randohinn/RVP/Hardware/WeP_reciever/RVP.pdf

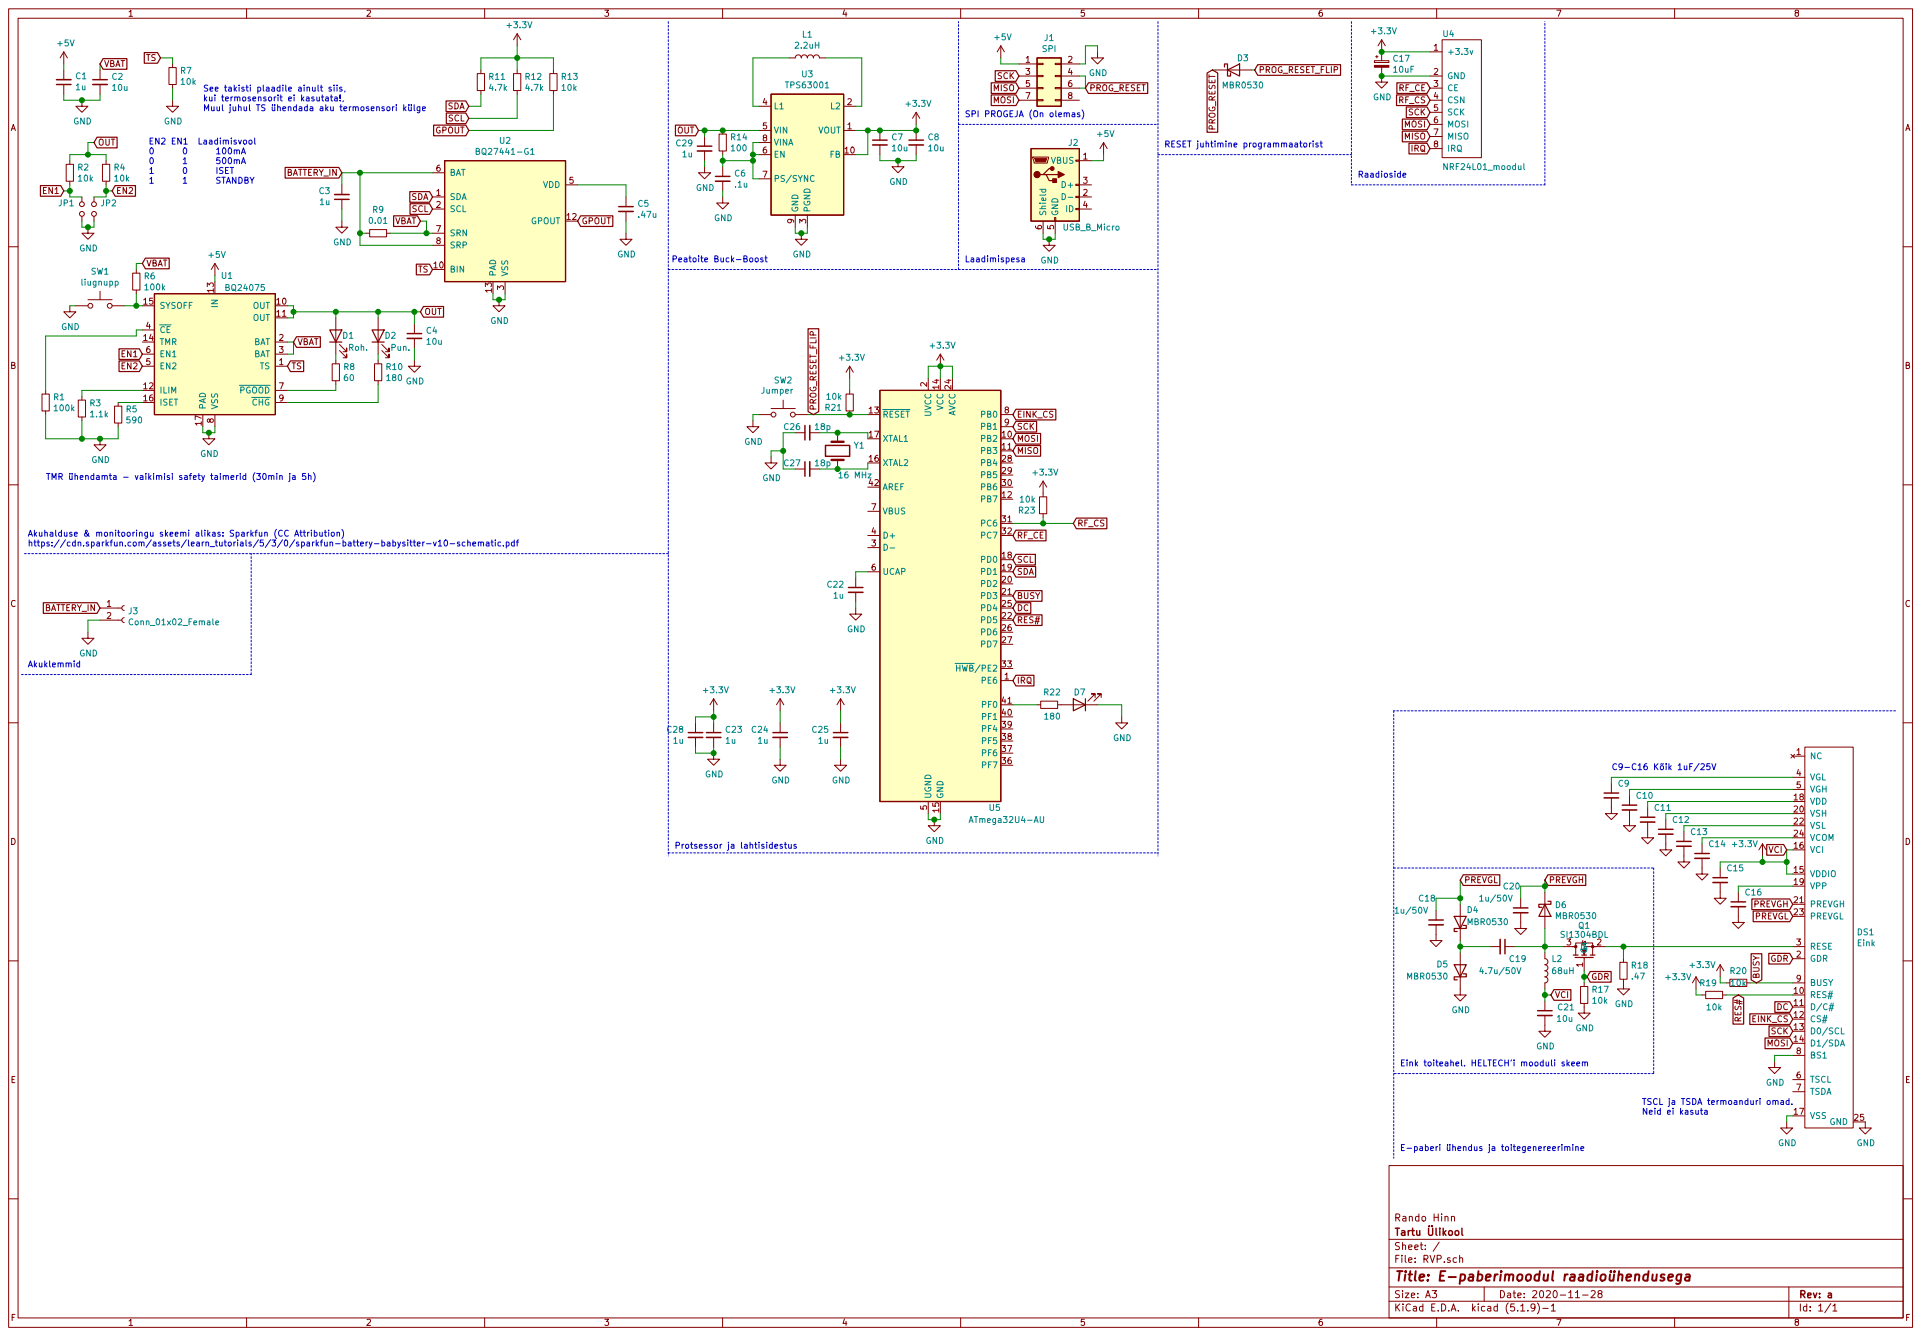
[picture p1: page 1]

See takisti plaadile ainult siis, kui termosensorit ei kasutata!, Muul juhul TS ühendada aku termosensori külge

3 VDD 5 BAT 6 SRN 7 SRP 8 U2 BQ27441-G1 C9

2 PD2 20 PD3 21 PD5 22 AVCC 24 PD4 25 PD6 26 PD7 27 PB4 28 PB5 29 D- 3 PB6 30 PC6 31 PC7 32 HWB/PE2 33 PF7 36 PF6 37 PF5 38 PF4 39 D+ 4 PF1 40 PF0 41 AREF 42 UGND

https://cdn.sparkfun.com/assets/learn_tutorials/5/3/0/sparkfun-battery-babysitter-v10-schematic.pdf Akuklemmid TMR ühendamta - vaikimisi safety taimerid (30min ja 5h)

Akuhalduse & monitooringu skeemi alikas: Sparkfun (CC Attribution)

Eink toiteahel. HELTECH'i mooduli skeem

TSCL ja TSDA termoanduri omad. Neid ei kasuta

File: RVP.sch Sheet: / Tartu Ülikool Rando Hinn

Id: 1/1 Title: E-paberimoodul raadioühendusega
