randohinn/RVP/Hardware/WeP_transmitter/RVP_saatja.pdf

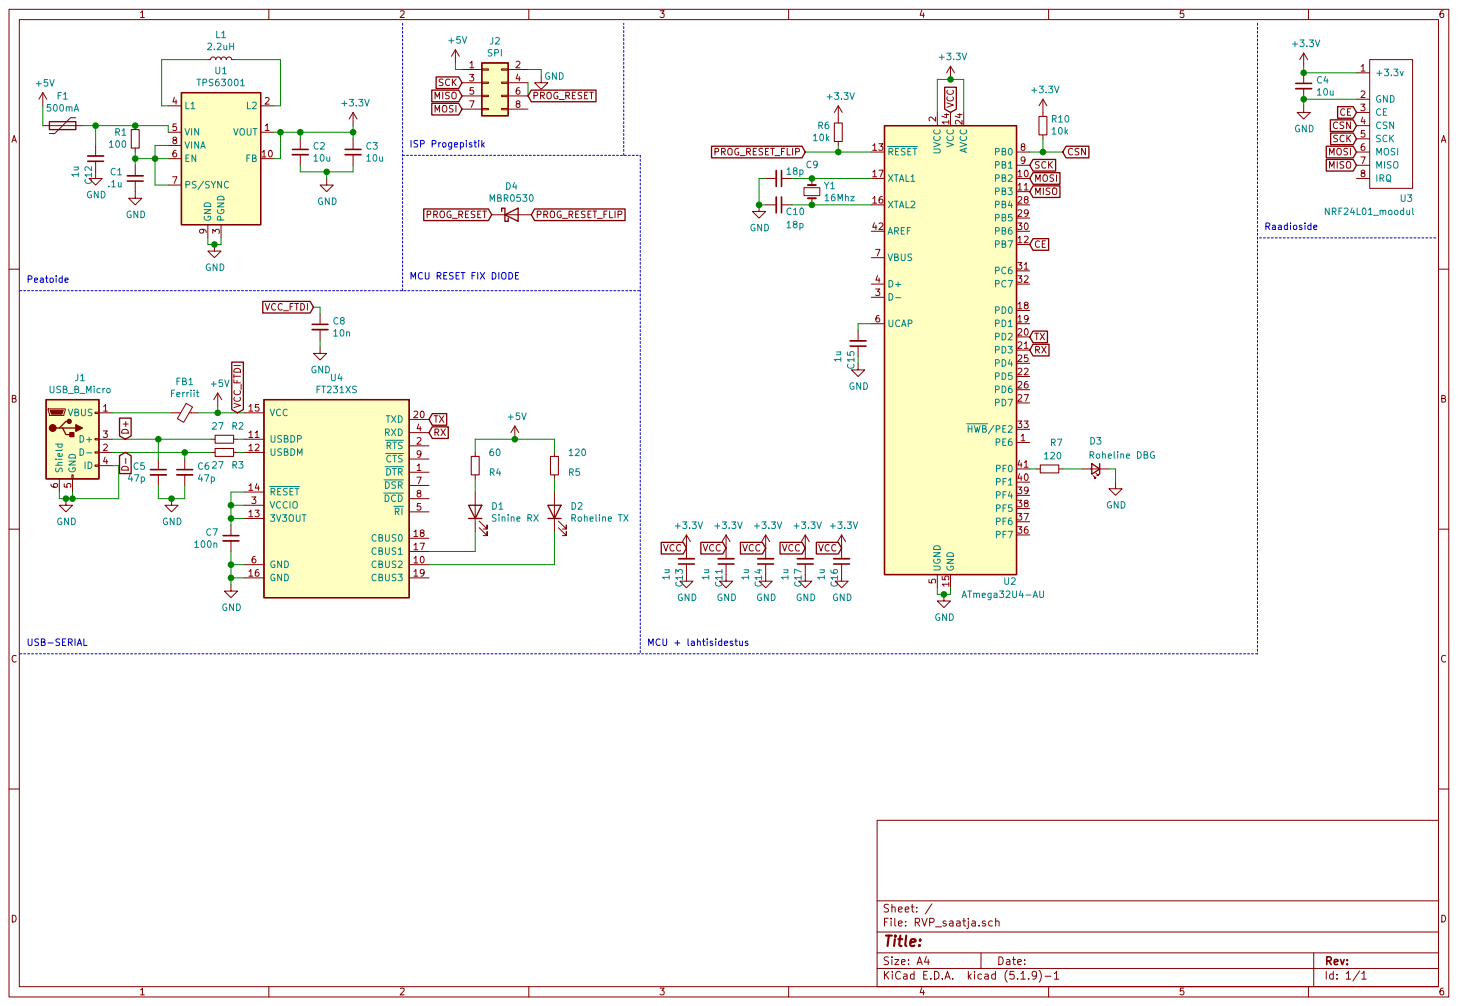
[picture p2: page 1]

9 U1 TPS63001 PE6 1 PB2 10 PB3 11 PB7 12 RESET 13 VCC 14 GND 15 XTAL2 16 XTAL1 17 PD0 18 PD1 19 UVCC

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
