randohinn/RVP/Hardware/WeP_reciever/RVP.kicad_pcb

## KiCad design Hardware/WeP_reciever/RVP.kicad_pcb (2021-02-10)

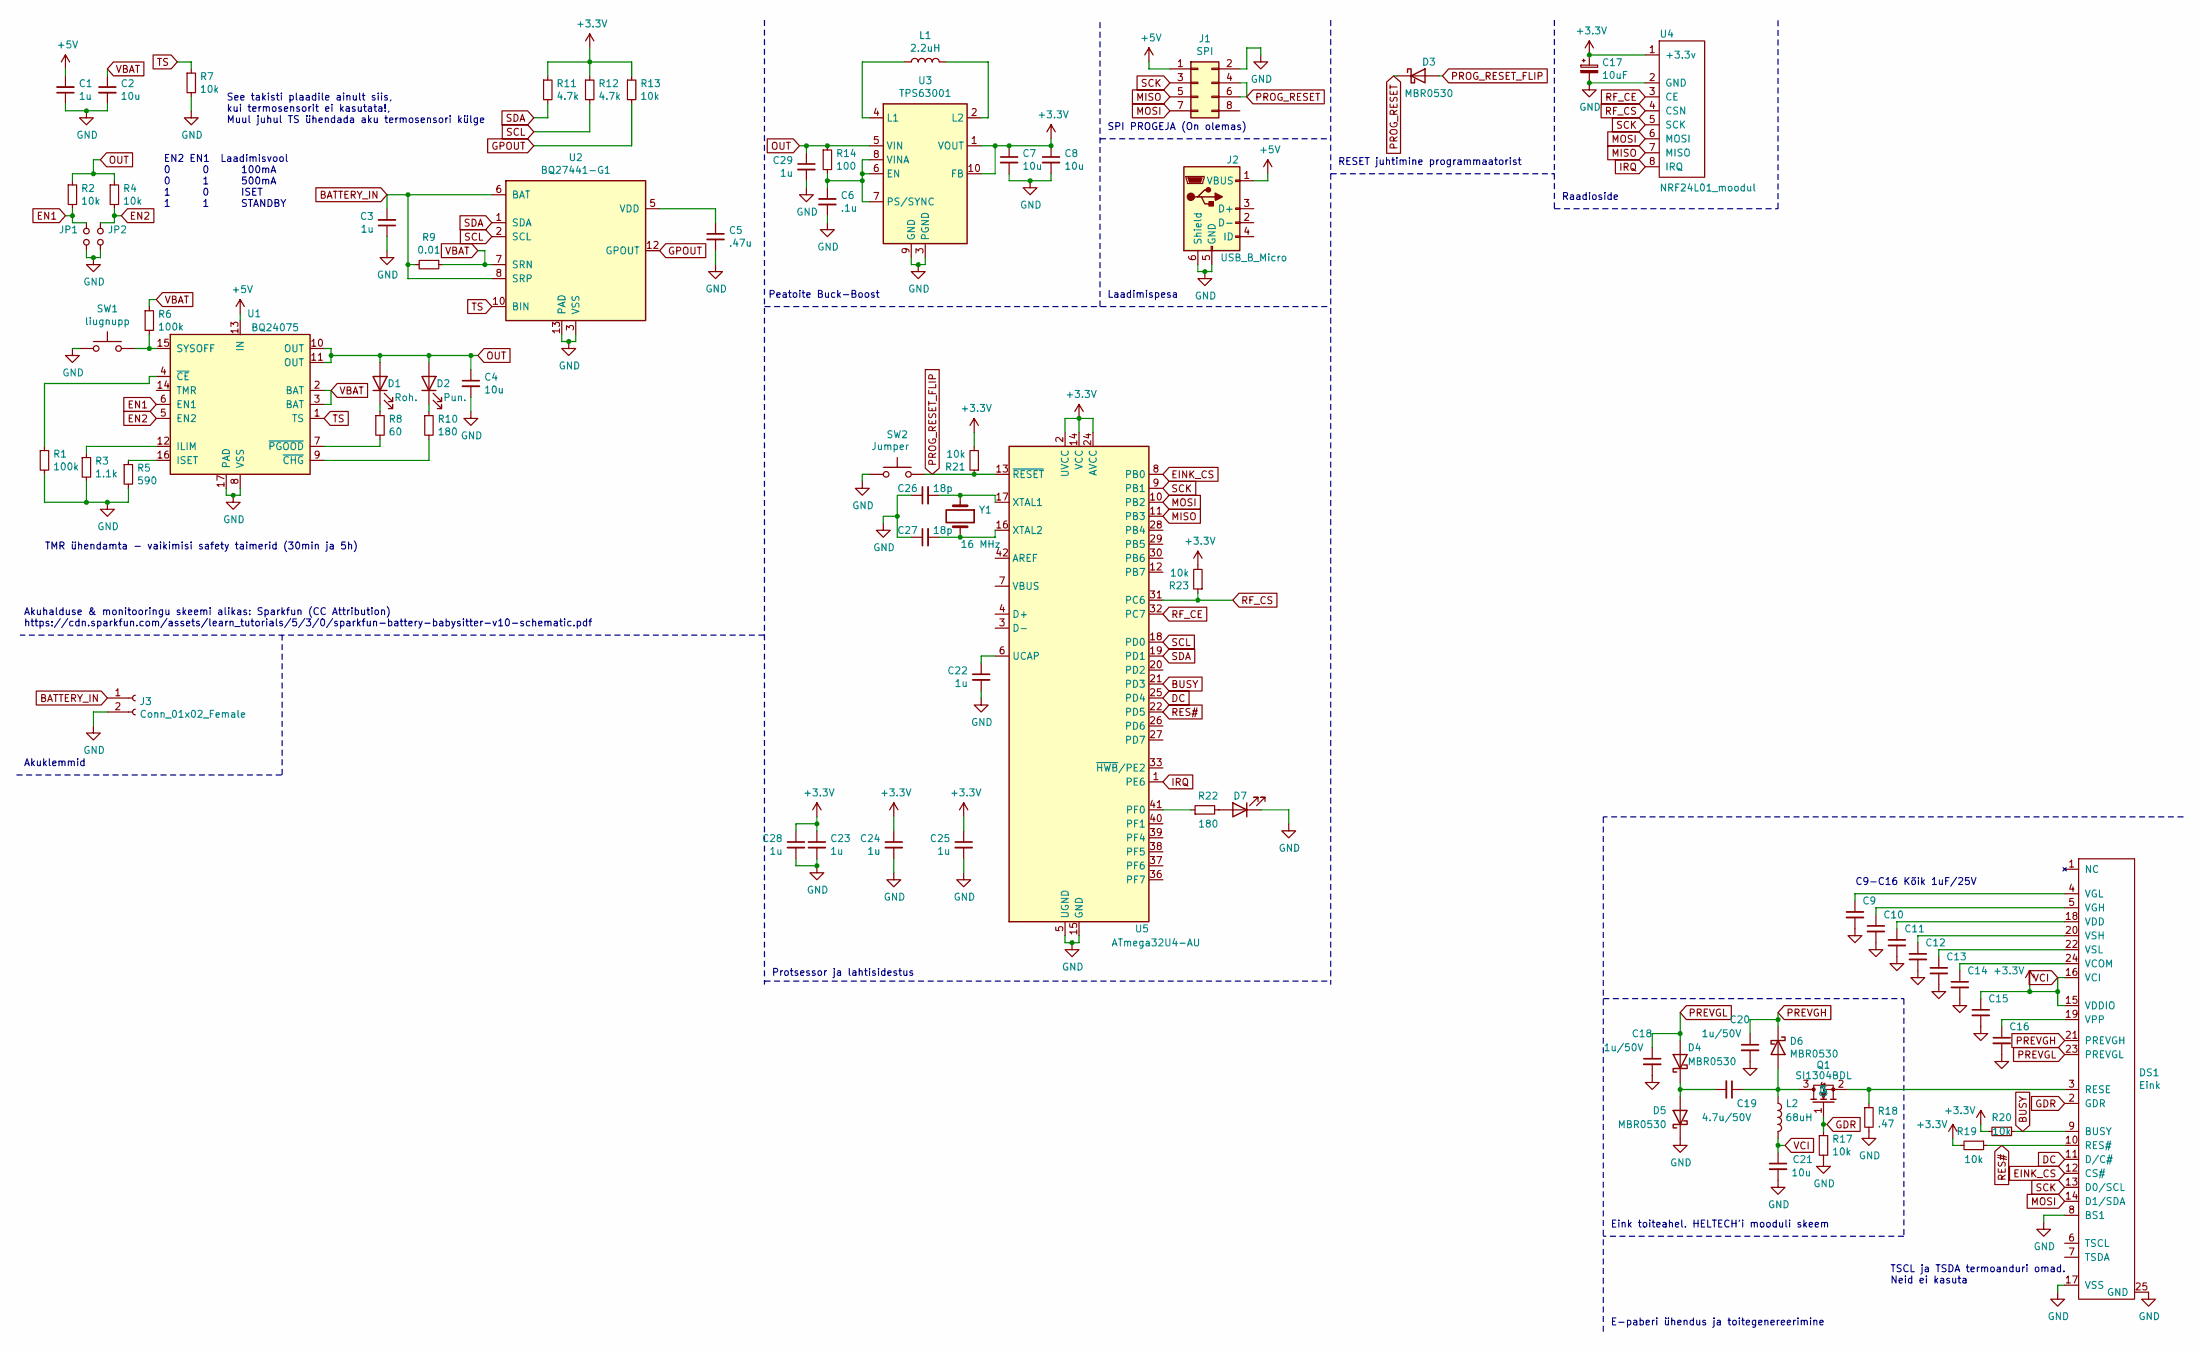
[picture p3: schematic RVP.sch, E-paberimoodul raadioühendusega]

Parts:
C1, C3, C9, C10, C11, C12, C13, C14, C15, C16, C22, C23, C24, C25, C28, C29: 1u; C_0603_1608Metric
C2, C4, C7, C8, C21: 10u; C_0603_1608Metric
C5: .47u; C_0603_1608Metric
C6: .1u; C_0603_1608Metric
C17: 10uF; CP_EIA-3528-15_AVX-H
C18, C20: 1u/50V; C_0603_1608Metric
C19: 4.7u/50V; C_0603_1608Metric
C26, C27: 18p; C_0603_1608Metric
D1: Roh.; LED_0603_1608Metric
D2: Pun.; LED_0603_1608Metric
D3, D4, D5, D6: MBR0530; D_SOD-123
D7: Sinine; LED_0603_1608Metric
DS1: Eink
J1: SPI; PinHeader_2x04_P2.54mm_Vertical
J2: USB_B_Micro; USB_Micro-B_Amphenol_10104110_Horizontal
J3: Conn_01x02_Female; Solderpads
JP1, JP2: Jumper_NO_Small; SolderJumper-2_P1.3mm_Open_Pad1.0x1.5mm
L1: 2.2uH; L_0603_1608Metric
L2: 68uH; L_0603_1608Metric
Q1: SI1304BDL; SOT-323_SC-70_Handsoldering
R1, R6: 100k; R_0603_1608Metric
R2, R4, R7, R13, R17, R19, R20, R21, R23: 10k; R_0603_1608Metric
R3: 1.1k; R_0603_1608Metric
R5: 590; R_0603_1608Metric
R8: 60; R_0603_1608Metric
R9: 0.01; R_0603_1608Metric
R10, R22: 180; R_0603_1608Metric
R11, R12: 4.7k; R_0603_1608Metric
R14: 100; R_0603_1608Metric
R18: .47; R_0603_1608Metric
SW1: liugnupp; MK12C02
SW2: Jumper; C_0603_1608Metric
U1: BQ24075; VQFN-16-1EP_3x3mm_P0.5mm_EP1.68x1.68mm
U2: BQ27441-G1; Texas_S-PDSO-N12
U3: TPS63001; Texas_DRC0010J_ThermalVias
U4: NRF24L01_moodul; NRF24L01 moodul SMD
U5: ATmega32U4-AU; TQFP-44_10x10mm_P0.8mm
Y1: 16 MHz; Crystal_SMD_TXC_7A-2Pin_5x3.2mm

Connections:
+5V: C1.2, J1.1, J2.1 (VBUS), U1.13 (IN)
BATTERY_IN: C3.2, J3.1, R9.2, U2.6 (BAT), U2.8 (SRP)
BUSY: DS1.9 (BUSY), R20.1, U5.21 (PD3)
DC: DS1.11 (D/C#), U5.25 (PD4)
EINK_CS: DS1.12 (CS#), U5.8 (PB0)
EN1: JP1.1, R2.2, U1.6 (EN1)
EN2: JP2.1, R4.2, U1.5 (EN2)
GDR: DS1.2 (GDR), Q1.1 (G), R17.1
GND: C1.1, C2.2, C3.1, C4.2, C5.2, C6.2, C7.2, C8.2, C9.2, C10.2, C11.2, C12.2, C13.2, C14.2, C15.2, C16.2, C17.2, C18.2, C20.2, C21.2, C22.2, C23.2, C24.2, C25.2, C26.1, C27.1, C28.2, C29.2, D5.1 (K), D7.1 (K), DS1.8 (BS1), DS1.17 (VSS), DS1.25 (GND), J1.2, J2.5 (GND), J2.6 (Shield), J3.2, JP1.2, JP2.2, R1.2, R3.2, R5.2, R7.2, R17.2, R18.2, SW1.2, SW2.1, U1.8 (VSS), U1.17 (PAD), U2.3 (VSS), U2.13 (PAD), U3.3 (PGND), U3.9 (GND), U3.11 (PGND), U4.2 (GND), U5.5 (UGND), U5.15 (GND), U5.23 (GND), U5.35 (GND), U5.43 (GND)
GPOUT: R13.2, U2.12 (GPOUT)
IRQ: U4.8 (IRQ), U5.1 (PE6)
MISO: J1.5, U4.7 (MISO), U5.11 (PB3)
MOSI: DS1.14 (D1/SDA), J1.7, U4.6 (MOSI), U5.10 (PB2)
unnamed: C5.1, U2.5 (VDD)
unnamed: C6.1, R14.2, U3.6 (EN), U3.7 (PS/SYNC), U3.8 (VINA)
unnamed: C9.1, DS1.4 (VGL)
unnamed: C10.1, DS1.5 (VGH)
unnamed: C11.1, DS1.18 (VDD)
unnamed: C12.1, DS1.20 (VSH)
unnamed: C13.1, DS1.22 (VSL)
unnamed: C14.1, DS1.24 (VCOM)
unnamed: C16.1, DS1.19 (VPP)
unnamed: C19.1, D6.2 (A), L2.1, Q1.3 (D)
unnamed: C19.2, D4.1 (K), D5.2 (A)
unnamed: C22.1, U5.6 (UCAP)
unnamed: C26.2, U5.17 (XTAL1), Y1.1
unnamed: C27.2, U5.16 (XTAL2), Y1.2
unnamed: D1.1 (K), R8.1
unnamed: D2.1 (K), R10.1
unnamed: D7.2 (A), R22.2
unnamed: DS1.3 (RESE), Q1.2 (S), R18.1
unnamed: L1.1, U3.4 (L1)
unnamed: L1.2, U3.2 (L2)
unnamed: R1.1, U1.4 (~CE)
unnamed: R3.1, U1.12 (ILIM)
unnamed: R5.1, U1.16 (ISET)
unnamed: R6.2, SW1.1, U1.15 (SYSOFF)
unnamed: R8.2, U1.7 (~PGOOD)
unnamed: R10.2, U1.9 (~CHG)
unnamed: R22.1, U5.41 (PF0)
OUT: C4.1, C29.1, D1.2 (A), D2.2 (A), R2.1, R4.1, R14.1, U1.10 (OUT), U1.11 (OUT), U3.5 (VIN)
PREVGH: C20.1, D6.1 (K), DS1.21 (PREVGH)
PREVGL: C18.1, D4.2 (A), DS1.23 (PREVGL)
PROG_RESET: D3.1 (K), J1.4, J1.6
PROG_RESET_FLIP: D3.2 (A), R21.1, SW2.2, U5.13 (~RESET)
RES#: DS1.10 (RES#), R19.1, U5.22 (PD5)
RF_CE: U4.3 (CE), U5.32 (PC7)
RF_CS: R23.1, U4.4 (CSN), U5.31 (PC6)
SCK: DS1.13 (D0/SCL), J1.3, U4.5 (SCK), U5.9 (PB1)
SCL: R12.2, U2.2 (SCL), U5.18 (PD0)
SDA: R11.2, U2.1 (SDA), U5.19 (PD1)
TS: R7.1, U1.1 (TS), U2.10 (BIN)
VBAT: C2.1, R6.1, R9.1, U1.2 (BAT), U1.3 (BAT), U2.7 (SRN)
VCI: C7.1, C8.1, C15.1, C17.1, C21.1, C23.1, C24.1, C25.1, C28.1, DS1.15 (VDDIO), DS1.16 (VCI), L2.2, R11.1, R12.1, R13.1, R19.2, R20.2, R21.2, R23.2, U3.1 (VOUT), U3.10 (FB), U4.1 (+3.3v), U5.2 (UVCC), U5.14 (VCC), U5.24 (AVCC), U5.34 (VCC), U5.44 (AVCC)

Notes on the sheet:
Akuhalduse & monitooringu skeemi alikas: Sparkfun (CC Attribution) https://cdn.sparkfun.com/assets/learn_tutorials/5/3/0/sparkfun-battery-babysitter-v10-schematic.pdf
See takisti plaadile ainult siis, kui termosensorit ei kasutata!, Muul juhul TS ühendada aku termosensori külge
TMR ühendamta - vaikimisi safety taimerid (30min ja 5h)
EN2 EN1 Laadimisvool 0 0 100mA 0 1 500mA 1 0 ISET 1 1 STANDBY
Peatoite Buck-Boost
SPI PROGEJA (On olemas)
Laadimispesa
RESET juhtimine programmaatorist
Raadioside
TSCL ja TSDA termoanduri omad. Neid ei kasuta
Eink toiteahel. HELTECH'i mooduli skeem
C9-C16 Kõik 1uF/25V
E-paberi ühendus ja toitegenereerimine
Protsessor ja lahtisidestus
Akuklemmid

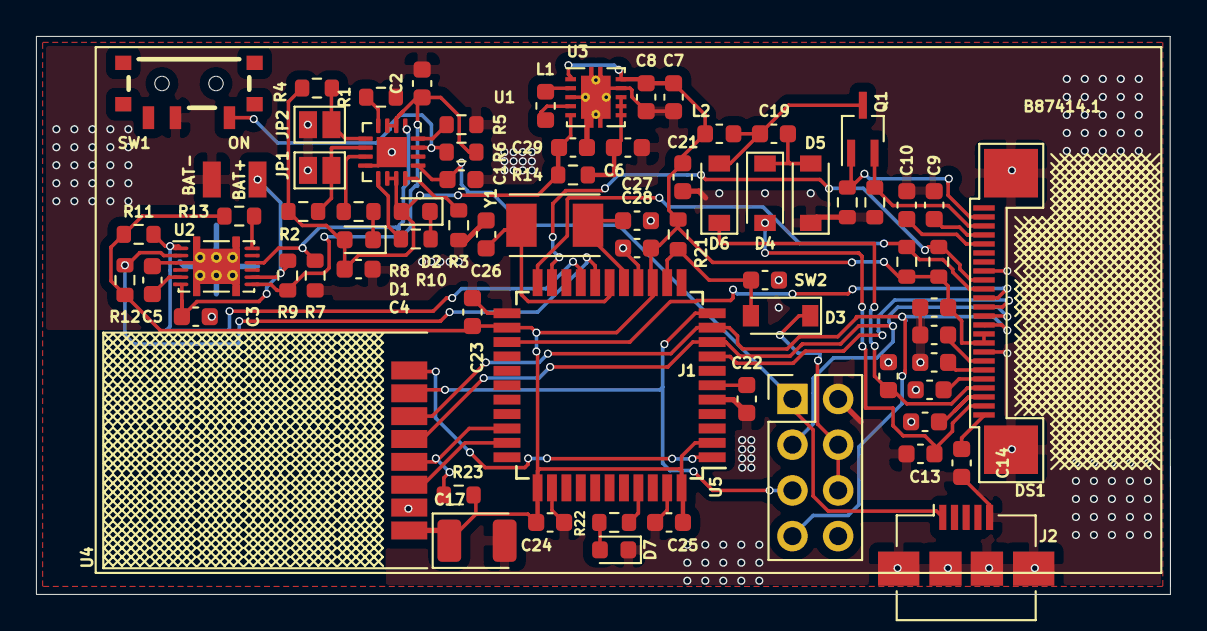
[picture p4: board RVP.kicad_pcb from above]

Board: 2 copper layers, 63.0 x 31.0 mm, 74 parts (0 on the bottom side), 54 nets.
