randohinn/RVP/Hardware/WeP_transmitter/RVP_saatja.kicad_pcb

## KiCad design Hardware/WeP_transmitter/RVP_saatja.kicad_pcb (2021-02-10)

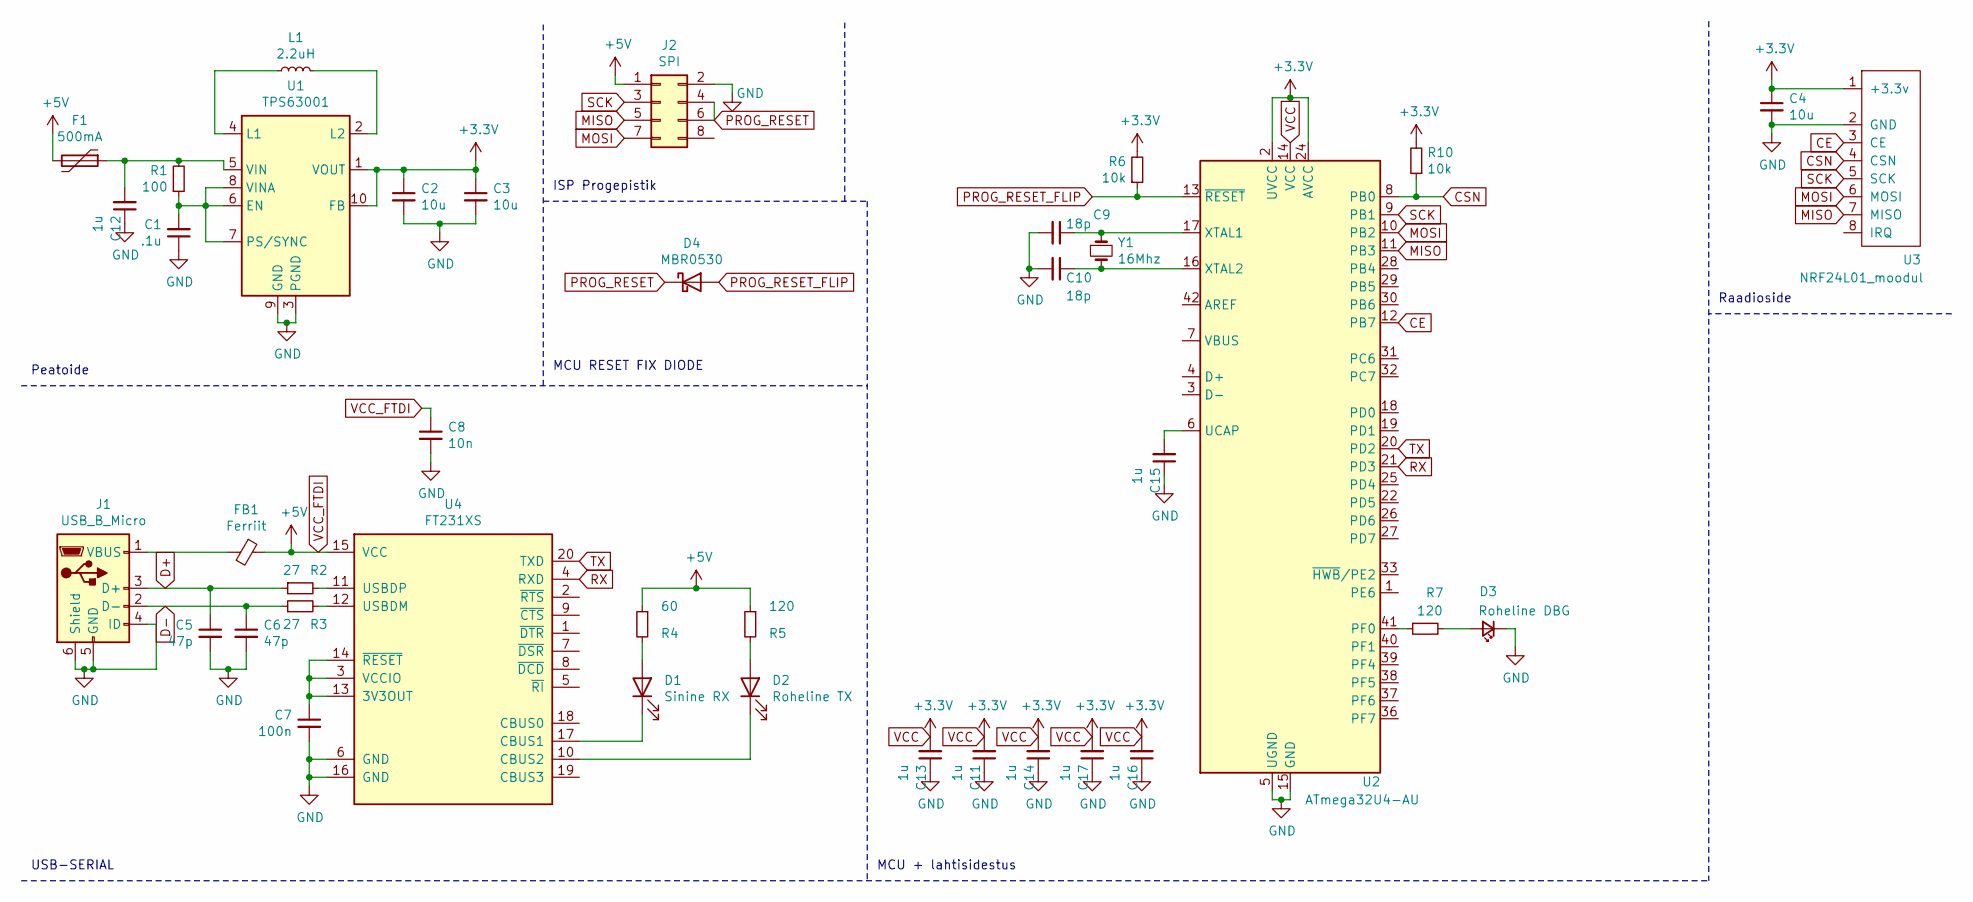
[picture p5: schematic RVP_saatja.sch]

Parts:
C1: .1u; C_0603_1608Metric
C2, C3: 10u; C_0603_1608Metric
C4: 10u; CP_EIA-3528-15_AVX-H
C5, C6: 47p; C_0603_1608Metric
C7: 100n; C_0603_1608Metric
C8: 10n; C_0603_1608Metric
C9, C10: 18p; C_0603_1608Metric
C11, C12, C13, C14, C15, C16, C17: 1u; C_0603_1608Metric
D1: Sinine RX; LED_0603_1608Metric
D2: Roheline TX; LED_0603_1608Metric
D3: Roheline DBG; LED_0603_1608Metric
D4: MBR0530; D_SOD-123
F1: 500mA; Fuse_1206_3216Metric
FB1: Ferriit; L_0603_1608Metric
J1: USB_B_Micro; USB_Micro-B_Amphenol_10104110_Horizontal
J2: SPI; PinHeader_2x04_P2.54mm_Vertical
L1: 2.2uH; L_0603_1608Metric
R1: 100; R_0603_1608Metric
R2, R3: 27; R_0603_1608Metric
R4: 60; R_0603_1608Metric
R5, R7: 120; R_0603_1608Metric
R6, R10: 10k; R_0603_1608Metric
U1: TPS63001; Texas_DRC0010J_ThermalVias
U2: ATmega32U4-AU; TQFP-44_10x10mm_P0.8mm
U3: NRF24L01_moodul; NRF24L01 moodul SMD
U4: FT231XS; SSOP-20_3.9x8.7mm_P0.635mm
Y1: 16Mhz; Crystal_SMD_TXC_7A-2Pin_5x3.2mm

Connections:
CE: U2.12 (PB7), U3.3 (CE)
CSN: R10.1, U2.8 (PB0), U3.4 (CSN)
D+: C5.1, J1.3 (D+), R2.1
D-: C6.1, J1.2 (D-), R3.1
GND: C1.1, C2.2, C3.2, C4.2, C5.2, C6.2, C7.2, C8.2, C9.2, C10.2, C11.1, C12.1, C13.1, C14.1, C15.1, C16.1, C17.1, D3.1 (K), J1.4 (ID), J1.5 (GND), J1.6 (Shield), J2.2, U1.3 (PGND), U1.9 (GND), U1.11 (PGND), U2.5 (UGND), U2.15 (GND), U2.23 (GND), U2.35 (GND), U2.43 (GND), U3.2 (GND), U4.6 (GND), U4.16 (GND)
MISO: J2.5, U2.11 (PB3), U3.7 (MISO)
MOSI: J2.7, U2.10 (PB2), U3.6 (MOSI)
unnamed: C1.2, R1.1, U1.6 (EN), U1.7 (PS/SYNC), U1.8 (VINA)
unnamed: C7.1, U4.3 (VCCIO), U4.13 (3V3OUT), U4.14 (~RESET)
unnamed: C9.1, U2.17 (XTAL1), Y1.1
unnamed: C10.1, U2.16 (XTAL2), Y1.2
unnamed: C12.2, F1.1, R1.2, U1.5 (VIN)
unnamed: C15.2, U2.6 (UCAP)
unnamed: D1.1 (K), U4.17 (CBUS1)
unnamed: D1.2 (A), R4.2
unnamed: D2.1 (K), U4.10 (CBUS2)
unnamed: D2.2 (A), R5.2
unnamed: D3.2 (A), R7.2
unnamed: FB1.2, J1.1 (VBUS)
unnamed: L1.1, U1.4 (L1)
unnamed: L1.2, U1.2 (L2)
unnamed: R2.2, U4.11 (USBDP)
unnamed: R3.2, U4.12 (USBDM)
unnamed: R7.1, U2.41 (PF0)
PROG_RESET: D4.1 (K), J2.4, J2.6
PROG_RESET_FLIP: D4.2 (A), R6.1, U2.13 (~RESET)
RX: U2.21 (PD3), U4.4 (RXD)
SCK: J2.3, U2.9 (PB1), U3.5 (SCK)
TX: U2.20 (PD2), U4.20 (TXD)
VCC: C2.1, C3.1, C4.1, C11.2, C13.2, C14.2, C16.2, C17.2, R6.2, R10.2, U1.1 (VOUT), U1.10 (FB), U2.2 (UVCC), U2.14 (VCC), U2.24 (AVCC), U2.34 (VCC), U2.44 (AVCC), U3.1 (+3.3v)
VCC_FTDI: C8.1, F1.2, FB1.1, J2.1, R4.1, R5.1, U4.15 (VCC)

Notes on the sheet:
Raadioside
Peatoide
USB-SERIAL
ISP Progepistik
MCU RESET FIX DIODE
MCU + lahtisidestus

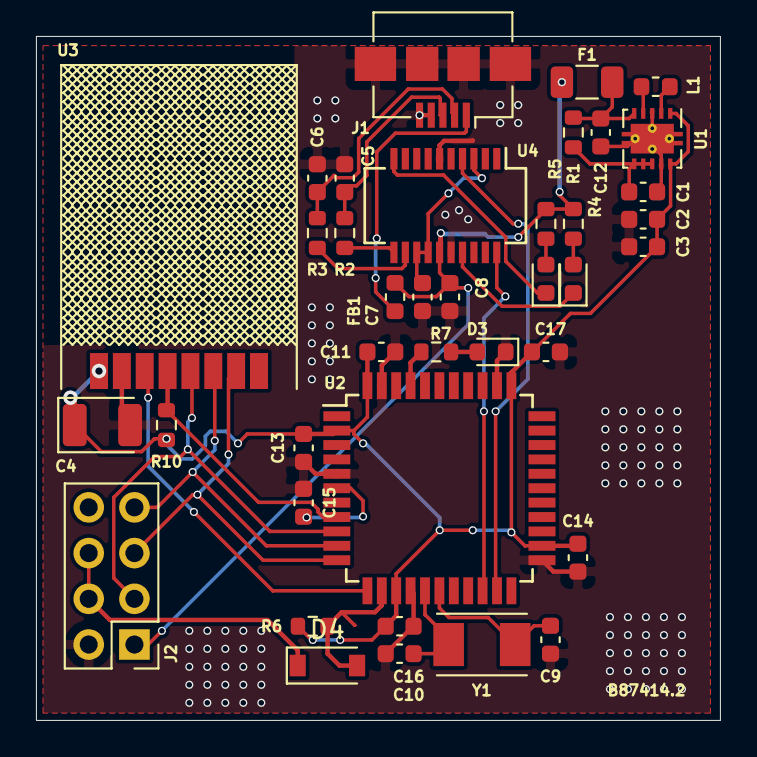
[picture p6: board RVP_saatja.kicad_pcb from above]

Board: 2 copper layers, 38.0 x 38.0 mm, 39 parts (0 on the bottom side), 31 nets.
