randohinn/RVP/Firmware/WeP-Transmitter/include/spi.h

#ifndef SPI_H
#define SPI_H
#include <avr/io.h>

/* Riistvaraprojekt UT 2020/21 - Rando Hinn,saatjamooduli SPI libra */


void SPI_init();

void SPI_unset_cs();
void SPI_set_cs();
void SPI_send(uint8_t data);


#endif
